0x444454/mandel_CmodA7/README.md

# mandel_CmodA7
## A fast (1.5 GigaIters/s) interactive Mandelbrot generator for the Digilent Cmod A7 FPGA board

Features:
- HDMI output: 960x544 @ 60Hz, 24-bit colors.
- Interactive controls via joystick board.
- 15 asynchronous parallel Mandelbrot cores for 1.5 GigaIters/s.
- Breadboard friendly.

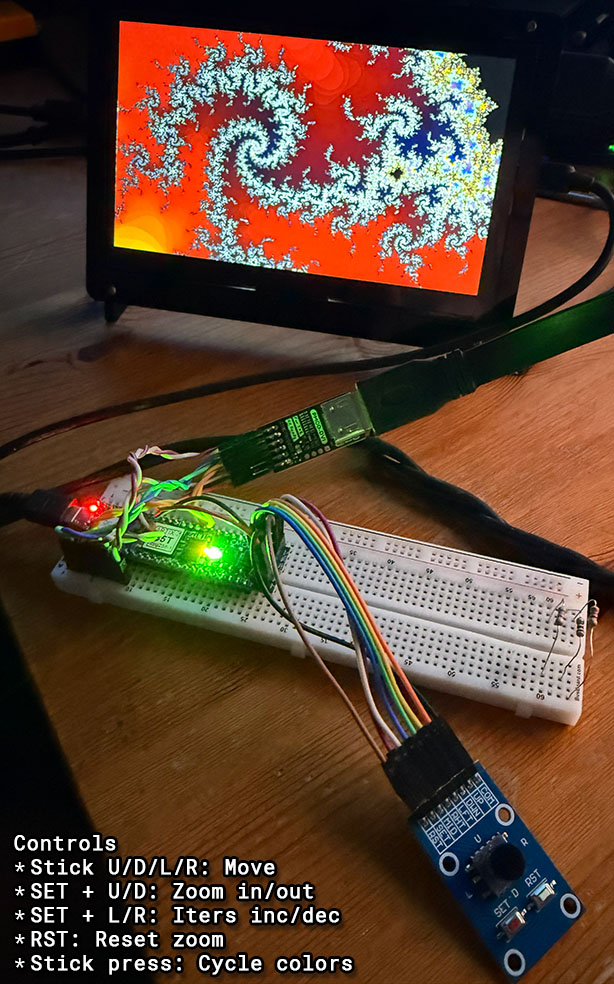
[picture p1: media/mandel_CmodA7-demo.jpg]


# REQUIREMENTS

- Digilent CmodA7 FPGA trainer board.
- PMOD-DVI module for HDMI output.
- Digital joystick board, with at least one action button.
- HDMI display.

# CONTROLS

Use the joystick:
- Up, Down, Left, Right: Move around in complex plane.  

Keep SET (button 1) pressed for these actions:
- SET + Up: Zoom in 2x.
- SET + Down: Zoom out 2x.
- SET + Left: Increase iterations.
- SET + Right: Decrese iterations.

Stick-press (button 2) to cycle color palette.  

Press RST (button 3) to reset zoom.  

Multicolor **LED**:
- Red = Calculating
- Green = Idle

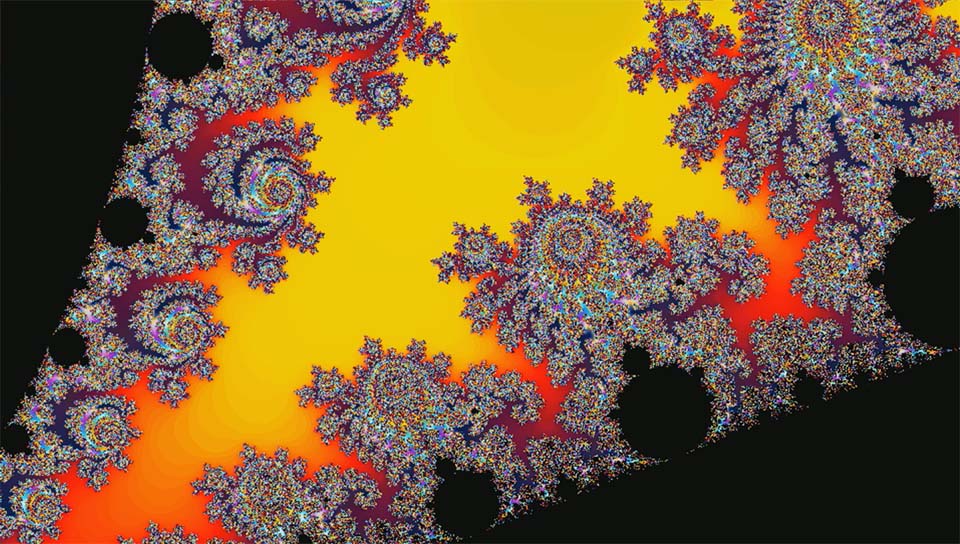
[picture p2: media/screenshot.jpg]


# SCHEMATICS

**WARNING**: Do __not__ use pin 24 ("VU") of the Cmod A7 board to power components.  
Voltage on that pin varies depending on power source (e.g. 5V if using USB power).  

**HDMI wiring**: Although we use a PMOD-DVI adapter, we cannot use the Cmod A7 PMOD connector.  
The reason is we need 4 differential pairs and direct connection to FPGA (no resistors), but the PMOD connector in the Cmod A7 has 200 Ω resistors on data pins, and only 3 differential pairs, so we need to wire HDMI on pins 26-33 of the board.  
Keep wires short and twist each p and n pair (see photo above).  
This PMOD adapter needs 3.3V, so we use 3V3 from the PMOD connector, and GND from PMOD (or pin 26 of the board, as you prefer).  

**Joystick wiring**: Connect a digital joystick board to PMOD.  
You need at least the 4 directions, and the main action button (here called "SET" button).  
A 3 button joystick allows more interactions (see [Controls](#CONTROLS)).  
NOTE: The joystick is a simple switch-to-ground type. Serial (I2C) controllers are __not__ supported.  

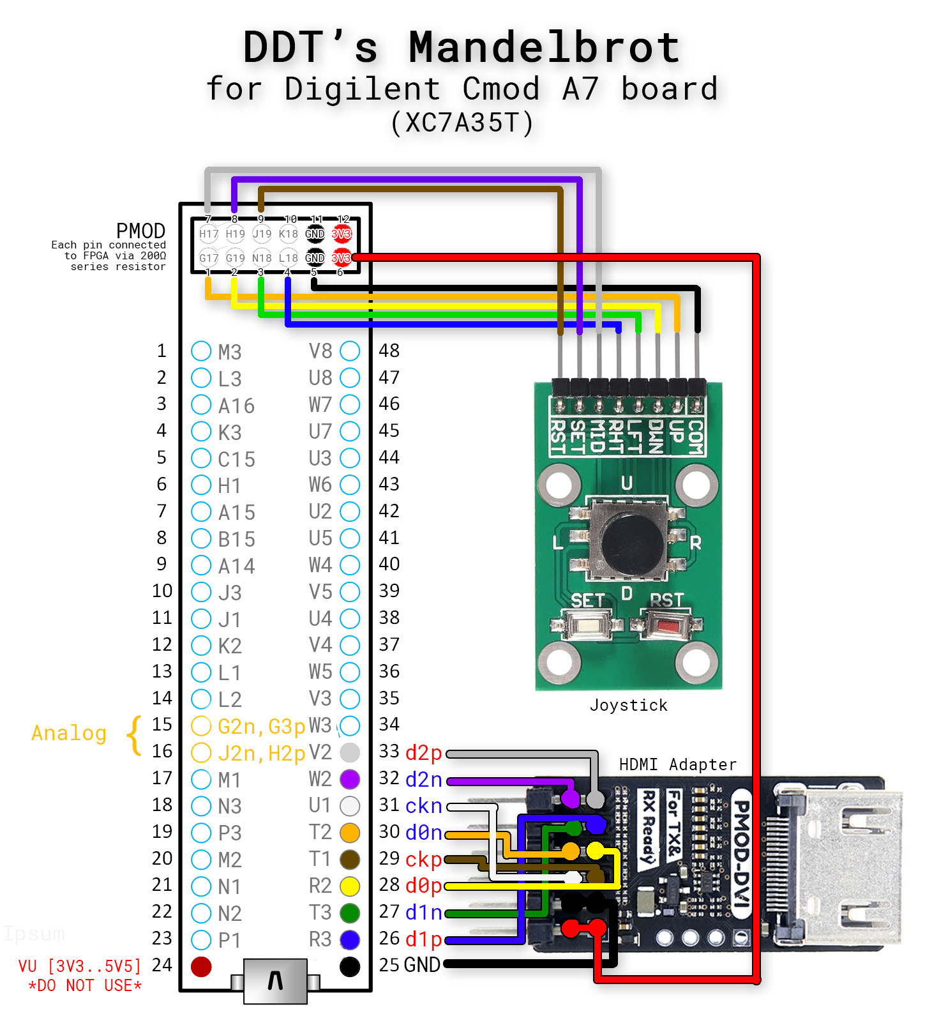
[picture p3: media/mandel_CmodA7-schematics.jpg]


# SUPPORTED RESOLUTIONS
- 960x544, RGB 8:8:8.

The default number of max iterations is 128, but the user can interactively change them in the range [16..4095].  

NOTE: The limited amount of SRAM (512 KB) in the Cmod A7 board only allows for a 960x544 framebuffer.
NOTE: The simple coloring algorithm maps the lowest 8-bits of a pixel iterations to a palette of 256 colors.

# ALGORITHM

### Mandelbrot calculation

This is a brute force algorithm using Q3.22 fixed-point precision.  
We don't need heuristic optimizations, as we can reach interactive rates also at the maximum 4095 iters/pixel.  
The dirty work is done by the **15 Mandelbrot calculation cores** working in parallel at 100 MHz.  
Each core uses 6 DSP48E1 resources on the FPGA to calculate 1 Mandelbrot iteration per clock cycle. Aggregate computational power of all 15 cores (90 DSP) is 1.5 GigaIters/sec.  

Each cycle, if a core has completed calculation, we write the result to a dual-ported BRAM framebuffer storing up to two lines of the image (960x2 pixels). We also schedule calculation of new pixels to free cores.  
When a line in BRAM is complete, we flush it to SRAM as soon as we can (HDMI output has priority over SRAM).

### Note about fixed-point precision

There are two different fixed-point notations using "Q" numbers. TI and ARM. I am using ARM notation. More info here:  
https://en.wikipedia.org/wiki/Q_(number_format)  

The current implementation uses Q3.22 (25 bits total).  
The Mandelbrot set is contained in a circle with radius 2. However, during calculation, numbers greater than 2 are encountered, depending on the point being calculated.  
Here is the maximum magnitude reached for each point during the calculation:  

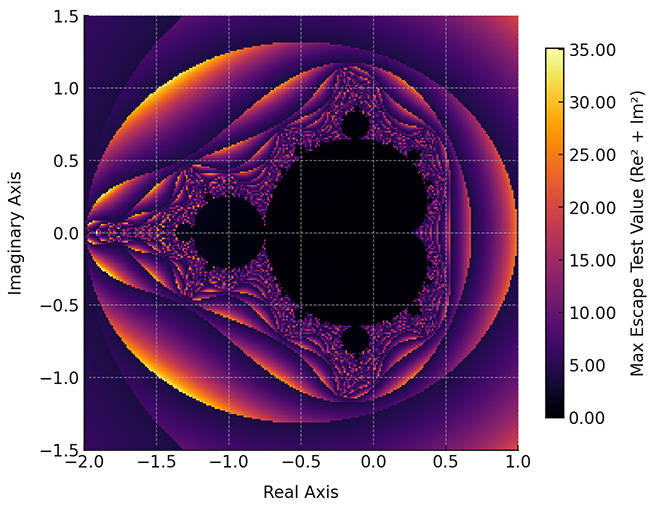
[picture p4: media/max_values.jpg]


Q3.22 (25 bits) is the best compromise between max-zoom and speed for the Artix7 FPGA.  
We use 25-bit numbers to maximize usage of DSP48E1 resources in the Artix7.  
Even if we use 25-bits number, we can perform the Mandel escape test on mult partials using more bits. This is unlikely many CPU mult implementations, and allows using only 3 bits (Q3) for the integral part of the calculation registers, and allocate more bits (22) to the fractional part for a deeper zoom.

### FPGA Utilization

This is on a Xilinx XC7A35T. Notice how we use all 90 (100%) DSP48E1 blocks and only 3% BRAM (as HDMI and calculation buffers), while other FPGA resources are mostly free. 
We also use almost all external SRAM for the framebuffer (960x544 = 522240 bytes out of 524288).

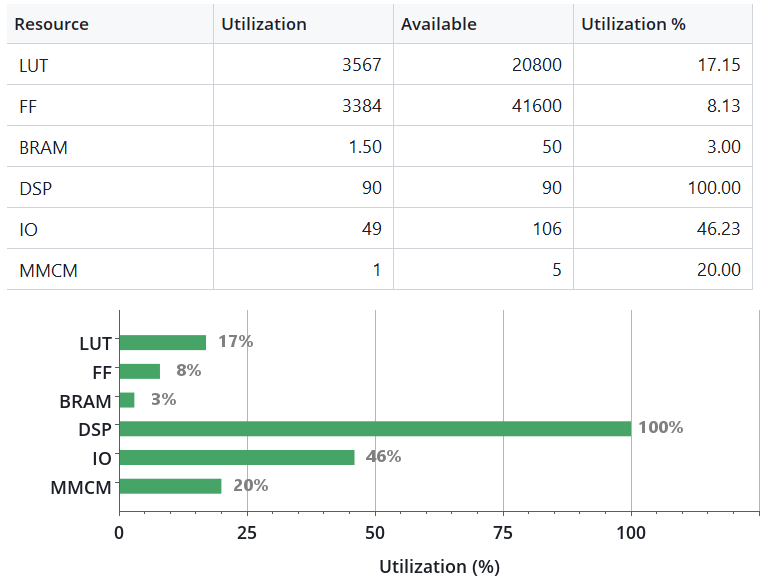
[picture p5: media/mandel_CmodA7-FPGA_summary.png]


# HI-LEVEL ARCH

screenshots

# PROBLEMS / FAQ

### I get no valid signal or no sync on my display

- Make sure you are using the right HDMI adapter. Some of them are made for a different board, and do not have the right resistors for the Cmod A7.
- Review [Schematics](#SCHEMATICS).
- Make sure you __twisted__ each of the 4 HDMI pairs together (i.e. P and N signals). Have 0.5 to 1 twist per cm (1.25 to 2.5 twists per inch).
- Use shorter HDMI wires from FPGA pins to PMOD adapter (see pic of my setup), and make sure they are __all the same length__.
- Use shorter HDMI cable from adapter to display. I use a 1 meter (3 feet) cable.
- Remove possible sources of electromagnetic interference around our "contraption" :-)
- Try with a different display. Unfortunately, I have a limited amount of displays to test (3 out of 3 are working).

### Is my Cmod A7-15T supported ?

I only have a Cmod A7-35T, but the 15T should work after decreasing the number of Mandel cores to 7. This is because the 15T has half the DSPs of the 35T.
See [build instructions](sources/README.md) for more info.

### Why resolution is only 960x544 ?

The Cmod A7 board only has 512 KB (524288 bytes) of SRAM. We use one byte per pixel and fill it almost completely because 960x544 = 522240.  
Note that height is 544 instead of 540 (1080/2), otherwise many displays will think we are using 1080i (interlaced).

I tried upscaling to 1920x1080 but my displays won't sync. I think this could be due to limitations of the Cmod A7 (or a bug in the upscaler :-).
So I decided to keep it simple.  

### Why only 256 colors, even if 4096 iters are supported ?

Same reason as above. We only have 512 KB for the framebuffer, so we only store the lowest 8 bits of the pixel iterations.

### Can I customize the palette ?

Sure. Change it here: [palette_rom_256x12.sv](sources/src/palette_rom_256x12.sv)

### I have a Basys 3 FPGA board. Will this work ?

No, but this will: https://github.com/0x444454/mandel_basys3

# LICENSE

Creative Commons, CC BY

https://creativecommons.org/licenses/by/4.0/deed.en

Please add a link to this github project.
